xuanvuong1702/camera-4G/hardware/kicad/CAM4G/CAM4G-bom.csv

Reference | Value | Footprint | Qty
BT1 | CR1220 | Battery_Panasonic_CR1220-VCN_Vertical_CircularHoles | 1
C1 | 10uF | C_0603_1608Metric | 1
C2 | 100nF | C_0603_1608Metric | 1
C3 | 3.3uF | C_0603_1608Metric | 1
C4 | 47uF | C_0603_1608Metric | 1
C5 | 2.2nF | C_0603_1608Metric | 1
C6 | 100nF | C_0603_1608Metric | 1
C7 | 47nF | C_0603_1608Metric | 1
C8 | DNP | C_0603_1608Metric | 1
C9 | 1uF | C_0603_1608Metric | 1
C10 | 4.7uF | C_0603_1608Metric | 1
C11 | 10uF | C_0603_1608Metric | 1
C12 | 100nF | C_0603_1608Metric | 1
C13 | 10uF | C_0603_1608Metric | 1
C14 | 10uF | C_0603_1608Metric | 1
C15 | 100nF | C_0603_1608Metric | 1
C16 | 100nF | C_0603_1608Metric | 1
C17 | 100nF | C_0603_1608Metric | 1
C18 | 1uF | C_0603_1608Metric | 1
C19 | 100nF | C_0603_1608Metric | 1
D1 | RED | LED_0603_1608Metric | 1
D2 | GRN | LED_0603_1608Metric | 1
D3 | PWR | LED_0603_1608Metric | 1
D5 | BAT54 | D_SOD-323 | 1
D6 | BAT54 | D_SOD-323 | 1
J1 | USB-C | USB_C_Receptacle_HRO_TYPE-C-31-M-12 | 1
J2 | BAT | JST_VH_B2P-VH_1x02_P3.96mm_Vertical | 1
J3 | CAM 20P | Hirose_FH12-20S-0.5SH_1x20-1MP_P0.50mm_Horizontal | 1
J4 | microSD | microSD_HC_Hirose_DM3AT-SF-PEJM5 | 1
J6 | PIR | JST_XH_B3B-XH-A_1x03_P2.50mm_Vertical | 1
J7 | IR LED | JST_XH_B2B-XH-A_1x02_P2.50mm_Vertical | 1
J8 | IR-CUT | JST_XH_B2B-XH-A_1x02_P2.50mm_Vertical | 1
J9 | DS18B20 | JST_XH_B3B-XH-A_1x03_P2.50mm_Vertical | 1
J10 | DS18B20 | JST_XH_B3B-XH-A_1x03_P2.50mm_Vertical | 1
J11 | MODEM | PinHeader_2x06_P1.27mm_Vertical | 1
J12 | DEBUG UART | PinHeader_1x03_P2.54mm_Vertical | 1
J13 | SWD | PinHeader_1x04_P2.54mm_Vertical | 1
L1 | 1.2uH | L_Bourns-SRN8040_8x8.15mm | 1
L2 | 2.2uH | L_Bourns-SRN4018 | 1
NTC1 | 10k B3950 | R_0603_1608Metric | 1
Q1 | AO3401 | SOT-23 | 1
Q2 | 2N3904 | SOT-23 | 1
Q3 | AO3400A | SOT-23 | 1
R1 | 178k | R_0603_1608Metric | 1
R2 | 56k | R_0603_1608Metric | 1
R3 | 267k | R_0603_1608Metric | 1
R4 | 64.9k | R_0603_1608Metric | 1
R5 | 10.5k | R_0603_1608Metric | 1
R6 | 267k | R_0603_1608Metric | 1
R7 | 0.01R | R_2512_6332Metric | 1
R8 | 4.7k | R_0603_1608Metric | 1
R9 | 4.7k | R_0603_1608Metric | 1
R10 | 2.4k | R_0603_1608Metric | 1
R11 | 1k | R_0603_1608Metric | 1
R12 | 1k | R_0603_1608Metric | 1
R13 | 7.15k | R_0603_1608Metric | 1
R14 | 5.1k | R_0603_1608Metric | 1
R15 | 5.1k | R_0603_1608Metric | 1
R16 | 100k | R_0603_1608Metric | 1
R17 | 10k | R_0603_1608Metric | 1
R18 | 100k | R_0603_1608Metric | 1
R19 | 100R | R_0603_1608Metric | 1
R20 | 100k | R_0603_1608Metric | 1
R21 | 1k | R_0603_1608Metric | 1
R23 | 10k | R_0603_1608Metric | 1
R24 | 0R | R_0603_1608Metric | 1
R25 | 10k | R_0603_1608Metric | 1
R31 | 0R | R_0603_1608Metric | 1
R32 | 0R | R_0603_1608Metric | 1
R33 | 0R | R_0603_1608Metric | 1
R34 | 10k | R_0603_1608Metric | 1
R35 | 10k | R_0603_1608Metric | 1
SW1 | RESET | SW_SPST_B3S-1000 | 1
TP1 | TP_3V3 | TestPoint_Pad_1.5x1.5mm | 1
TP2 | TP_1V8 | TestPoint_Pad_1.5x1.5mm | 1
U1 | Core1106 | Core1106-SMT | 1
U2 | TPS61088 | VQFN-20_3.5x3.5 | 1
U3 | TPS62840 | SON_DLC_1.5x2 | 1
U4 | INA226 | MSOP-10_3x3mm_P0.5mm | 1
U5 | CN3058E | SOIC-8-1EP_3.9x4.9mm_P1.27mm_EP2.41x3.3mm | 1
U6 | STM32L011F4 | TSSOP-20_4.4x6.5mm_P0.65mm | 1
