xuanvuong1702/camera-4G/hardware/kicad/CAM4G/CAM4G.step

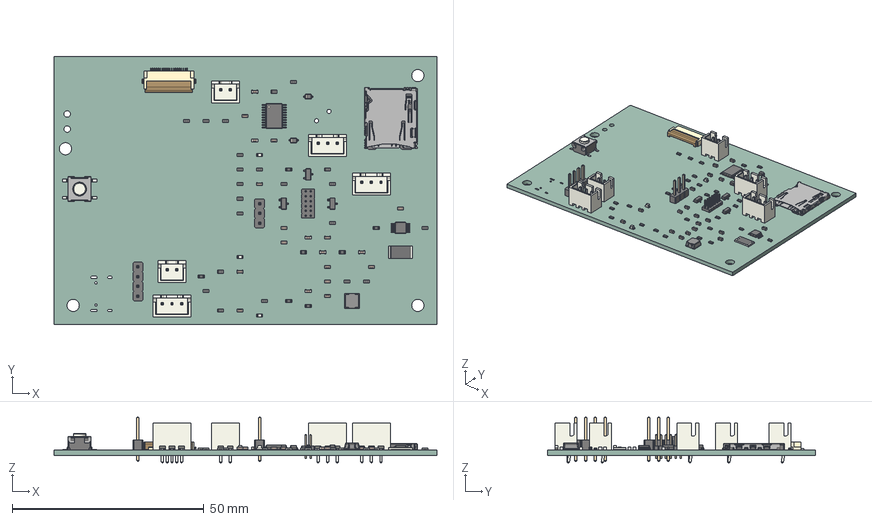
[picture p1: CAD file, 2026-11-09]
hardware/kicad/CAM4G/CAM4G.step
100.0 x 70.0 x 11.9 mm
C_0603_1608Metric x 19
R_0603_1608Metric x 29
LED_0603_1608Metric x 3
D_SOD-323 x 2
MSOP-10_3x3mm_P0.5mm
L_Bourns-SRN4018
R_2512_6332Metric
PinHeader_1x03_P254mm_Vertical
JST_B2B_XH_A x 2
lock
pins
JST_B3B_XH_A x 3
PinHeader_1x04_P254mm_Vertical
SOT-23 x 3
TSSOP-20_4.4x6.5mm_P0.65mm
PinHeader_2x06_P127mm_Vertical
microSD_HC_Hirose_DM3AT-SF-PEJM5
SW_SPST_B3S-1000
CAM4G_PCB
