xuanvuong1702/camera-4G/hardware/kicad/CAM4G/CAM4G-schematic-preview.pdf

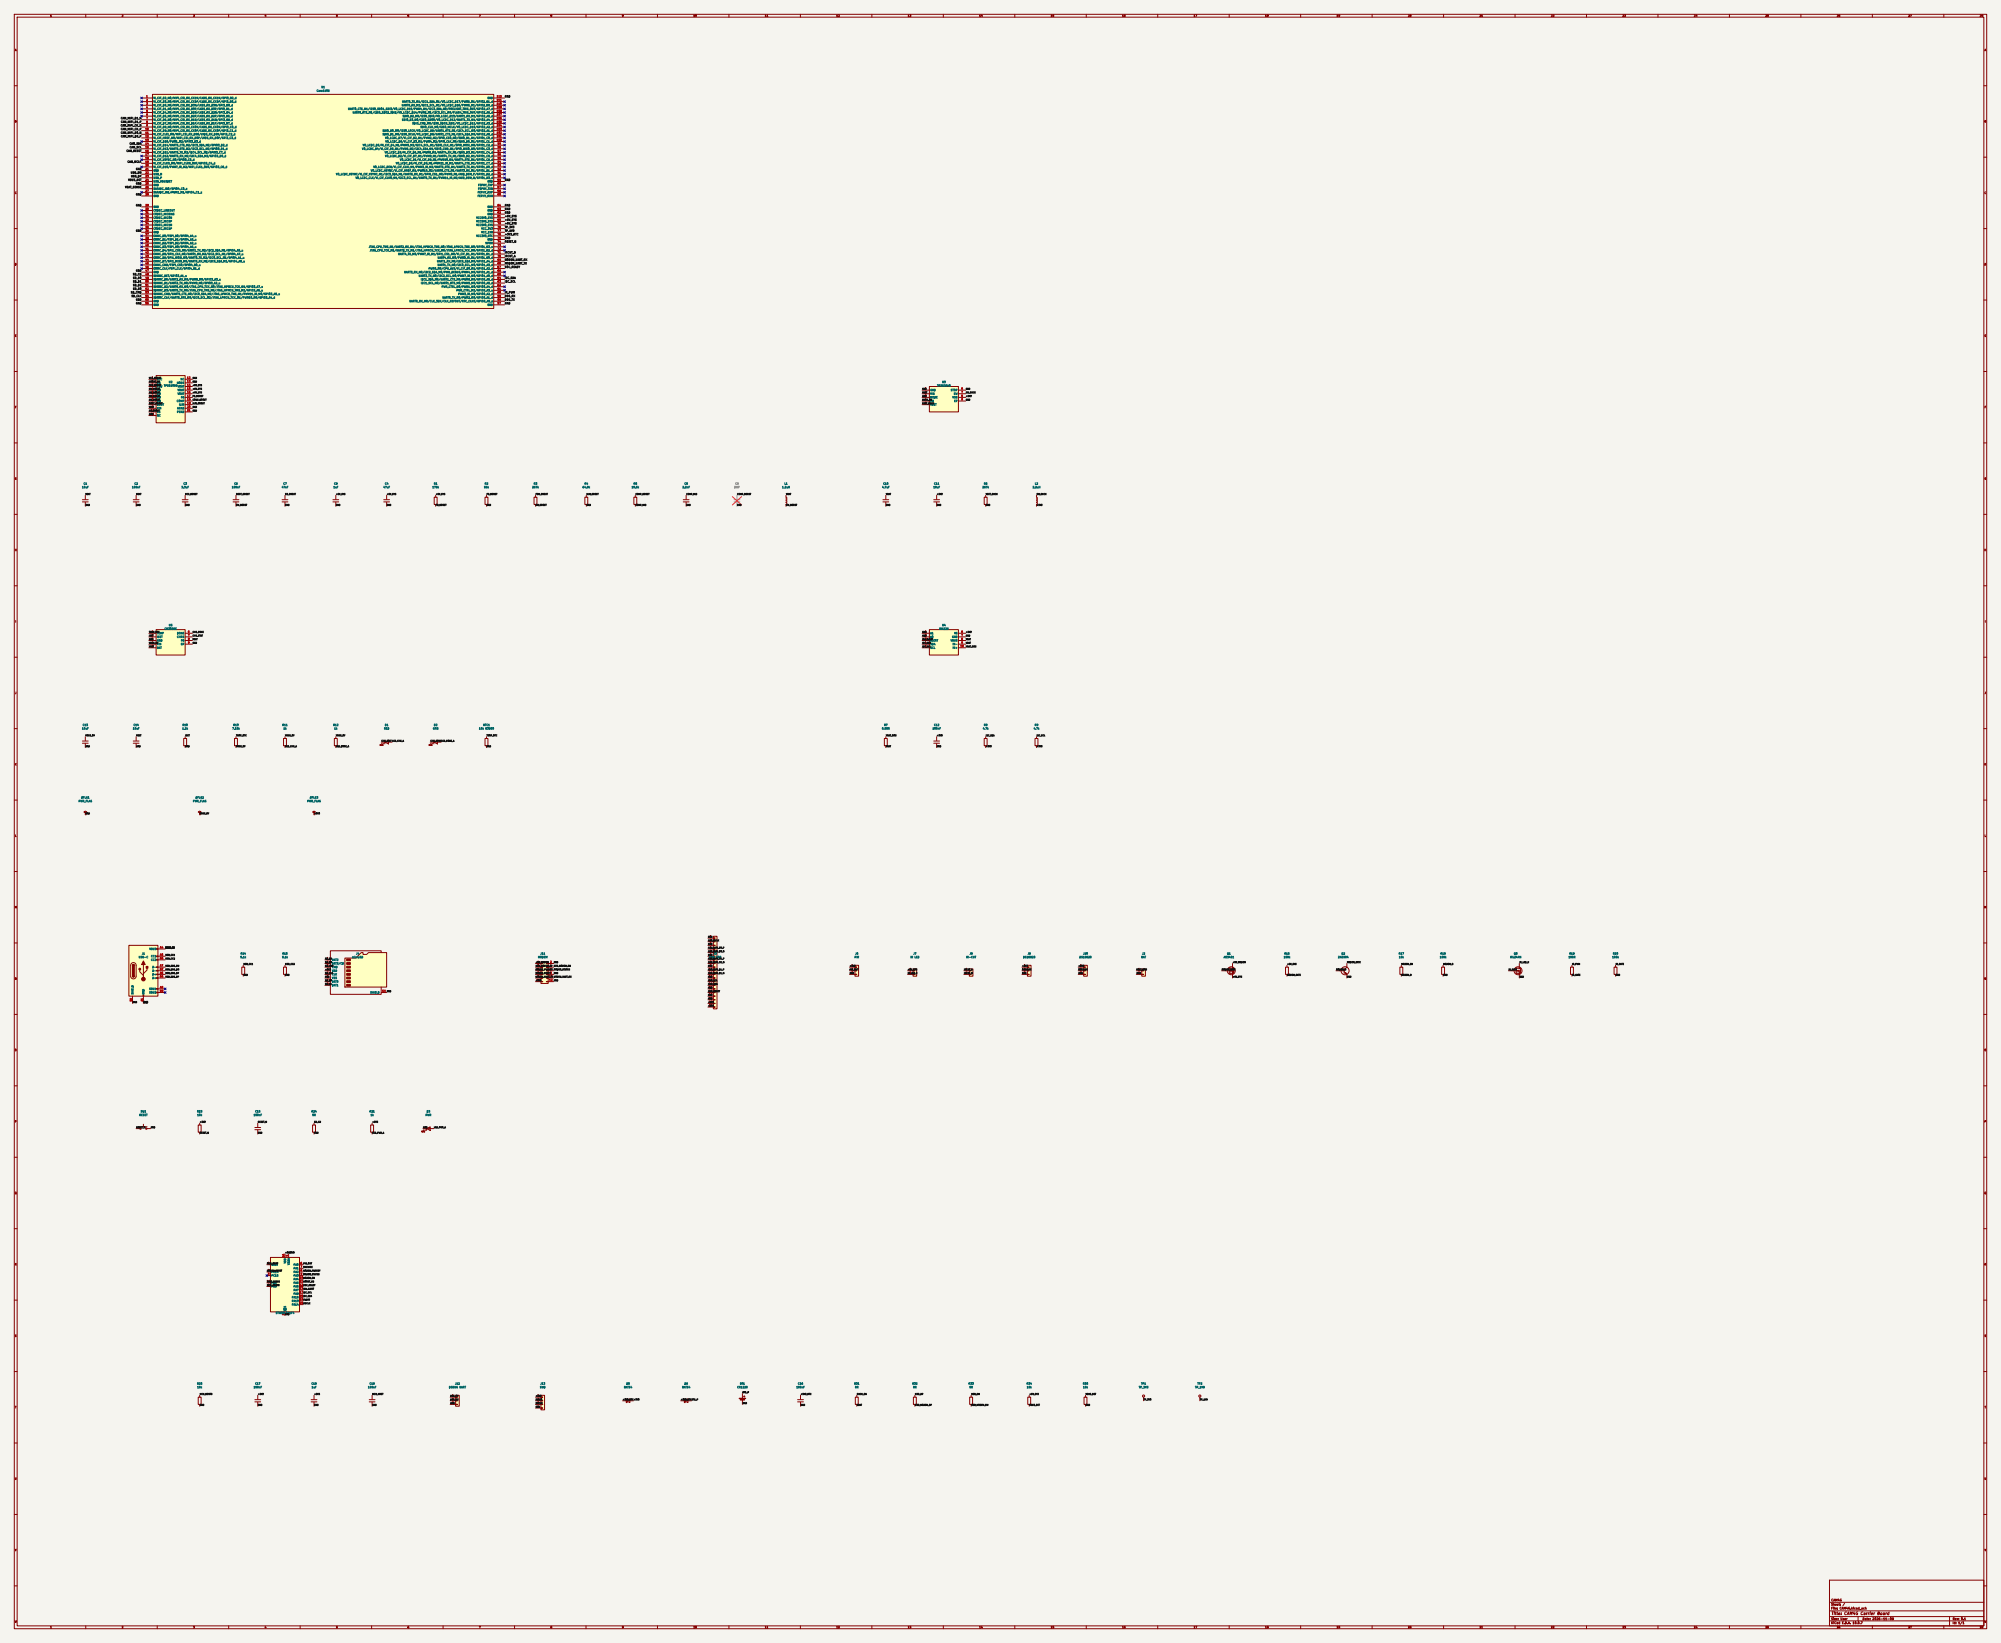
[picture p2: page 1]

Size: User | Rev: 0.1
KiCad E.D.A. 10.0.7 | Id: 1/1
