xuanvuong1702/camera-4G/hardware/kicad/CAM4G/CAM4G-1to1.pdf

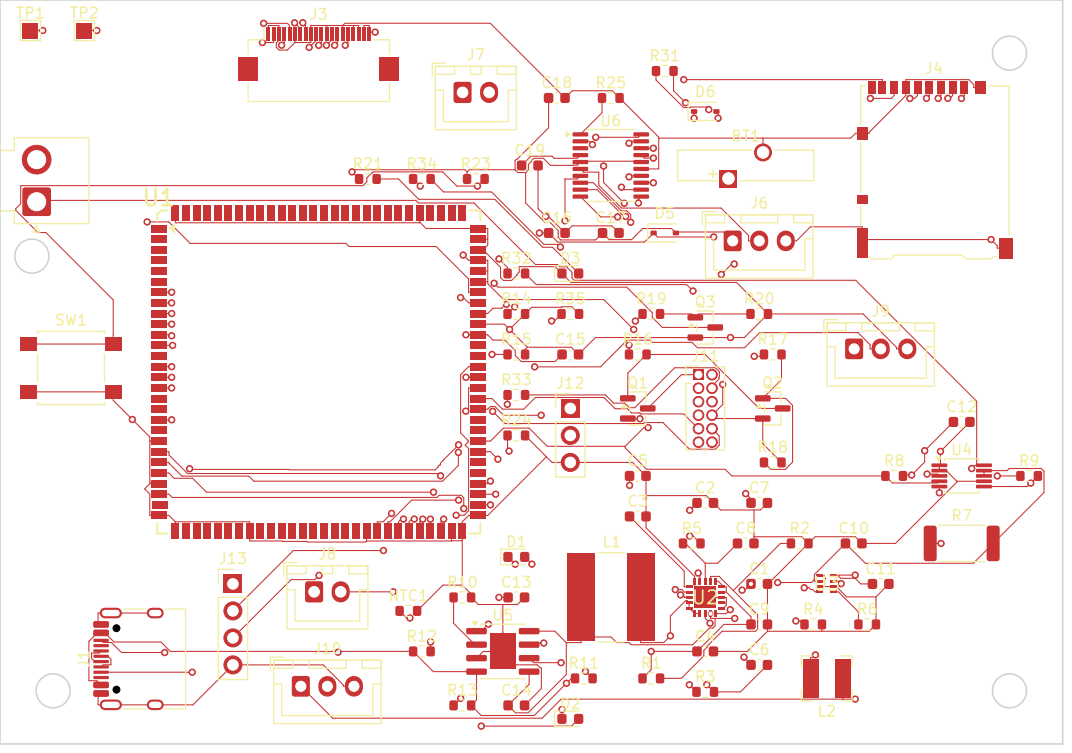
[picture p3: page 1]
