xuanvuong1702/camera-4G/hardware/kicad/CAM4G/CAM4G-pcb-preview.pdf

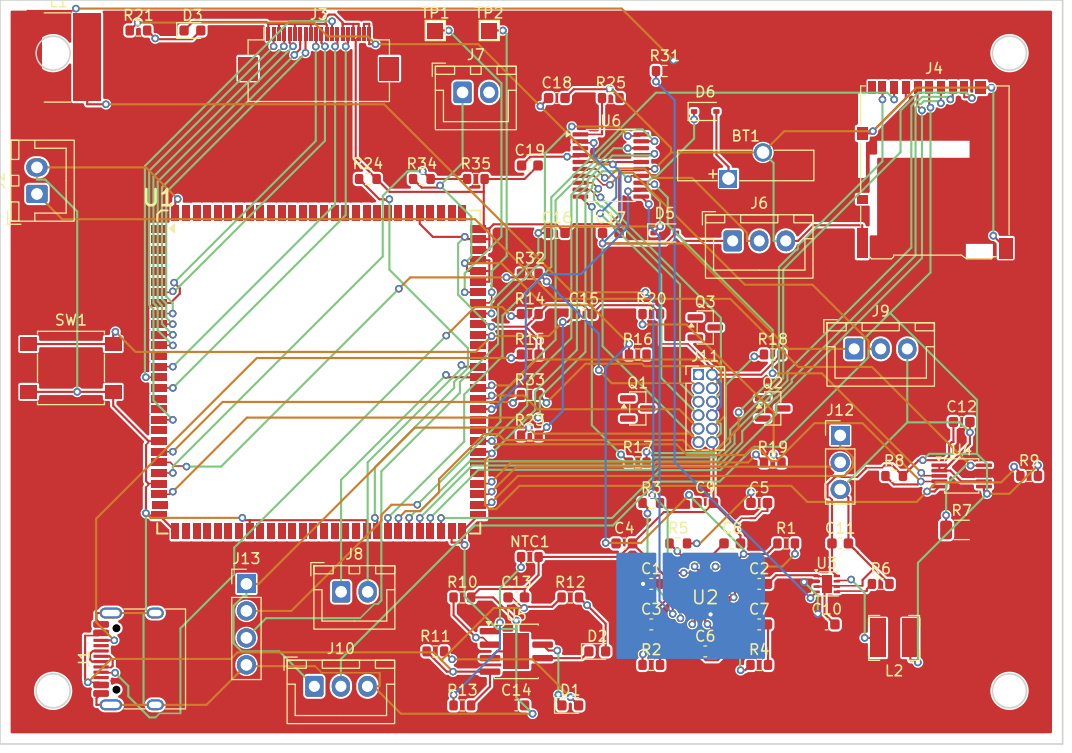
[picture p4: page 1]
