xuanvuong1702/camera-4G/hardware/kicad/CAM4G/CAM4G.kicad_pcb

## KiCad design hardware/kicad/CAM4G/CAM4G.kicad_pcb (2026-11-09)

Schematic: CAM4G.kicad_sch, CAM4G Carrier Board

Parts:
BT1: CR1220; Battery_Panasonic_CR1220-VCN_Vertical_CircularHoles
C1, C11, C13, C14: 10uF; C_0603_1608Metric
C2, C6, C12, C15, C16, C17, C19: 100nF; C_0603_1608Metric
C3: 3.3uF; C_0603_1608Metric
C4: 47uF; C_0603_1608Metric
C5: 2.2nF; C_0603_1608Metric
C7: 47nF; C_0603_1608Metric
C8: DNP; C_0603_1608Metric; not fitted
C9, C18: 1uF; C_0603_1608Metric
C10: 4.7uF; C_0603_1608Metric
D1: RED; LED_0603_1608Metric
D2: GRN; LED_0603_1608Metric
D3: PWR; LED_0603_1608Metric
D5, D6: BAT54; D_SOD-323
J1: USB-C; USB_C_Receptacle_HRO_TYPE-C-31-M-12
J2: BAT; JST_VH_B2P-VH_1x02_P3.96mm_Vertical
J3: CAM 20P; Hirose_FH12-20S-0.5SH_1x20-1MP_P0.50mm_Horizontal
J4: microSD; microSD_HC_Hirose_DM3AT-SF-PEJM5
J6: PIR; JST_XH_B3B-XH-A_1x03_P2.50mm_Vertical
J7: IR LED; JST_XH_B2B-XH-A_1x02_P2.50mm_Vertical
J8: IR-CUT; JST_XH_B2B-XH-A_1x02_P2.50mm_Vertical
J9, J10: DS18B20; JST_XH_B3B-XH-A_1x03_P2.50mm_Vertical
J11: MODEM; PinHeader_2x06_P1.27mm_Vertical
J12: DEBUG UART; PinHeader_1x03_P2.54mm_Vertical
J13: SWD; PinHeader_1x04_P2.54mm_Vertical
L1: 1.2uH; L_Bourns-SRN8040_8x8.15mm
L2: 2.2uH; L_Bourns-SRN4018
NTC1: 10k B3950; R_0603_1608Metric
Q1: AO3401; SOT-23
Q2: 2N3904; SOT-23
Q3: AO3400A; SOT-23
R1: 178k; R_0603_1608Metric
R2: 56k; R_0603_1608Metric
R3, R6: 267k; R_0603_1608Metric
R4: 64.9k; R_0603_1608Metric
R5: 10.5k; R_0603_1608Metric
R7: 0.01R; R_2512_6332Metric
R8, R9: 4.7k; R_0603_1608Metric
R10: 2.4k; R_0603_1608Metric
R11, R12, R21: 1k; R_0603_1608Metric
R13: 7.15k; R_0603_1608Metric
R14, R15: 5.1k; R_0603_1608Metric
R16, R18, R20: 100k; R_0603_1608Metric
R17, R23, R25, R34, R35: 10k; R_0603_1608Metric
R19: 100R; R_0603_1608Metric
R24, R31, R32, R33: 0R; R_0603_1608Metric
SW1: RESET; SW_SPST_B3S-1000
TP1: TP_3V3; TestPoint_Pad_1.5x1.5mm
TP2: TP_1V8; TestPoint_Pad_1.5x1.5mm
U1: Core1106; Core1106-SMT
U2: TPS61088; VQFN20_3.5
U3: TPS62840; DLC0008B
U4: INA226; MSOP-10_3x3mm_P0.5mm
U5: CN3058E; SOIC-8-1EP_3.9x4.9mm_P1.27mm_EP2.41x3.3mm
U6: STM32L011F4; TSSOP-20_4.4x6.5mm_P0.65mm

Connections:
/+3V3: C11.1, C12.1, C17.1, C18.1, D5.2 (A), J3.19, J3.20, J4.4 (VDD), J6.1, J9.1, J10.1, J11.11, J13.1, L2.2, R8.2, R9.2, R21.1, R23.1, U3.8 (VOS), U4.6 (VS), U6.5 (VDDA), U6.16 (VDD)
/+3V3_RTC: C16.1, D5.1 (K), D6.1 (K), U1.76 (VCC3V3_RTC)
/+5V_MODEM: J11.1, Q1.3 (D)
/+5V_SYS: C4.1, C9.1, J7.1, Q1.2 (S), R1.1, R16.1, U1.79 (VCC5V0_SYS), U1.80 (VCC5V0_SYS), U1.81 (VCC5V0_SYS), U2.14 (VOUT), U2.15 (VOUT), U2.16 (VOUT)
/BOOST_EN: U2.2 (EN), U6.11 (PA5)
/BOOT_BOOST: C6.1, U2.8 (BOOT)
/BT1_P: BT1.1 (+), D6.2 (A)
/BUCK_EN: R31.1, U3.4 (EN)
/CAM_MCLK: J3.2, U1.19 (VI_CIF_CLKO_M0/MIPI_CLK0_OUT/GPIO3_C4_d)
/CAM_MIPI_CK_N: J3.8, U1.9 (VI_CIF_D8_M0/MIPI_CSI_RX_CK0N/LVDS_RX_C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)
/CAM_MIPI_CK_P: J3.7, U1.10 (VI_CIF_D9_M0/MIPI_CSI_RX_CK0P/LVDS_RX_C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)
/CAM_MIPI_D0_N: J3.5, U1.11 (VI_CIF_CLKI_M0/MIPI_CSI_RX_D0N/LVDS_RX_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)
/CAM_MIPI_D0_P: J3.4, U1.12 (VI_CIF_HREF_M0/MIPI_CSI_RX_D0P/LVDS_RX_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)
/CAM_MIPI_D1_N: J3.11, U1.7 (VI_CIF_D6_M0/MIPI_CSI_RX_D1N/LVDS_RX_D1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)
/CAM_MIPI_D1_P: J3.10, U1.8 (VI_CIF_D7_M0/MIPI_CSI_RX_D1P/LVDS_RX_D1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)
/CAM_RESET: J3.16, U1.16 (VI_CIF_D11/UART5_TX_M2/I2C4_SCL_M2/GPIO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)
/CAM_SCL: J3.13, U1.15 (VI_CIF_D13/UART5_RTS_M2/I2C3_SCL_M2/GPI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)
/CAM_SDA: J3.14, U1.14 (VI_CIF_D14/UART5_CTS_M2/I2C3_SDA_M2/GPI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)
/CHG_DONE: D2.1 (K), U5.6 (DONE)
/CHG_STAT: D1.1 (K), U5.7 (CHRG)
/COMP_BOOST: C8.1, R5.1, U2.18 (COMP)
/COMP_MID: C5.1, R5.2
/DBG_RX: J12.2, U1.59 (UART0_TX_M0/PWM2_M0/GPIO0_A1_d)
/DBG_TX: J12.1, U1.58 (UART0_RX_M0/CLK_32K/CLK_REFOUT/RTC_CLKO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)
/FB_BOOST: R1.2, R2.1, U2.17 (FB)
/FSW_BOOST: R3.1, U2.3 (FSW)
/GND: BT1.2 (-), C1.2, C2.2, C3.2, C4.2, C5.2, C7.2, C8.2, C9.2, C10.2, C11.2, C12.2, C13.2, C14.2, C15.2, C16.2, C17.2, C18.2, C19.2, D3.1 (K), J1.A1 (GND), J1.A12 (GND), J1.B1 (GND), J1.B12 (GND), J1.SH (SHIELD), J2.2, J3.1, J3.3, J3.6, J3.9, J3.12, J3.15, J3.17, J3.18, J4.6 (VSS), J4.SH (SHIELD), J6.3, J9.3, J10.3, J11.2, J11.8, J11.12, J12.3, J13.4, NTC1.2, Q2.2 (E), Q3.2 (S), R2.2, R4.2, R6.2, R10.2, R14.2, R15.2, R18.2, R20.2, R24.2, R25.2, R35.2, SW1.2, U1.21 (GND), U1.25 (GND), U1.28 (GND), U1.29 (GND), U1.36 (GND), U1.47 (GND), U1.55 (GND), U1.56 (GND), U1.57 (GND), U1.75 (GND), U1.82 (GND), U1.83 (GND), U1.84 (GND), U1.89 (GND), U1.112 (GND), U2.11 (NC), U2.12 (NC), U2.13 (MODE), U2.20 (AGND), U2.21 (PGND), U3.1 (GND), U3.3 (MODE), U3.6 (STOP), U4.1 (A1), U4.2 (A0), U4.7 (GND), U5.3 (GND), U5.9 (EP), U6.15 (VSS)
/I2C_SCL: R9.1, U1.63 (I2C1_SCL_M0/UART1_RTS_M0/PWM5_M0/GPIO0_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), U4.5 (SCL), U6.17 (PA9)
/I2C_SDA: R8.1, U1.64 (I2C1_SDA_M0/UART1_CTS_M0/PWM6_M0/GPIO0_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), U4.4 (SDA), U6.18 (PA10)
/ILIM_BOOST: R4.1, U2.19 (ILIM)
/INA_ALERT: U4.3 (ALERT), U6.13 (PA7)
/IRCUT_A: J8.1, U1.70 (UART4_RX_M0/PWM3_IR_M1/GPIO1_B0_d)
/IRCUT_B: J8.2, U1.71 (UART4_TX_M0/PWM7_IR_M1/SPI1_CS1_M0/VI_C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)
/IR_GATE: Q3.1 (G), R19.2, R20.1
/IR_LED_K: J7.2, Q3.3 (D)
/IR_PWM: R19.1, U1.60 (PWM3_IR_M0/GPIO0_A2_d)
/ISET: R10.1, U5.2 (ISET)
/LED_CHG_A: D1.2 (A), R11.2
/LED_DONE_A: D2.2 (A), R12.2
/LED_PWR_A: D3.2 (A), R21.2
/MCU_BOOT0: R25.1, U6.1 (PB9)
/MCU_NRST: C19.1, U6.4 (NRST)
/MODEM_B: Q2.1 (B), R17.2, R18.1
/MODEM_EN: R17.1, U6.10 (PA4)
/MODEM_GATE: Q1.1 (G), Q2.3 (C), R16.2
/MODEM_PWRKEY: J11.5, U6.8 (PA2)
/MODEM_RESET: J11.7, U6.2 (PC14)
/MODEM_STATUS: J11.6, U6.9 (PA3)
/MODEM_UART_RX: J11.10, U1.69 (UART1_RX_M0/I2C0_SDA_M0/GPIO1_A4_d)
/MODEM_UART_TX: J11.9, U1.68 (UART1_TX_M0/I2C0_SCL_M0/GPIO1_A3_d)
/ONEWIRE: J9.2, J10.2, U6.7 (PA1)
/PIR_OUT: J6.2, U6.6 (PA0)
/RESET_N: C15.1, R23.2, SW1.1, U1.74 (NPOR)
/SD_CD: R24.1, U1.48 (SDMMC_DET/GPIO3_A1_u)
/SD_CLK: J4.5 (CLK), U1.54 (SDMMC_CLK/UART5_RTS_M0/I2C0_SCL_M2/JTAG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)
/SD_CMD: J4.3 (CMD), U1.53 (SDMMC_CMD/UART5_CTS_M0/I2C0_SDA_M2/JTAG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)
/SD_D0: J4.7 (DAT0), U1.49 (SDMMC_D0/UART2_RX_M0/PWM8_M0/GPIO3_A3_u)
/SD_D1: J4.8 (DAT1), U1.50 (SDMMC_D1/UART2_TX_M0/PWM9_M0/GPIO3_A2_u)
/SD_D2: J4.1 (DAT2), U1.51 (SDMMC_D2/UART5_RX_M0/JTAG_CPU_TCK_M0/JT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)
/SD_D3: J4.2 (DAT3/CD), U1.52 (SDMMC_D3/UART5_TX_M0/JTAG_CPU_TMS_M0/JT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)
/SOC_READY: U1.67 (PWM0_M0/CPU_AVS/VI_CIF_D0_M1/GPIO1_A2_d), U6.12 (PA6)
/SS_BOOST: C7.1, U2.10 (SS)
/SWCLK: J13.3, U6.20 (PA14)
/SWDIO: J13.2, U6.19 (PA13)
/SW_BOOST: C6.2, L1.2, R3.2, U2.4 (SW), U2.5 (SW), U2.6 (SW), U2.7 (SW)
/SW_BUCK: L2.1, U3.7 (SW)
/TEMP_NTC: NTC1.1, R13.1, U5.1 (TEMP)
/TP_1V8: TP2.1, U1.77 (VCC_1V8)
/TP_3V3: TP1.1, U1.78 (VCC_3V3)
/USB_CC1: J1.A5 (CC1), R14.1
/USB_CC2: J1.B5 (CC2), R15.1
/USB_DBG_DM: J1.A7 (D-), J1.B7 (D-)
/USB_DBG_DP: J1.A6 (D+), J1.B6 (D+)
/USB_DM: R33.1, U1.22 (USB_N)
/USB_DP: R32.1, U1.23 (USB_P)
/USB_MODEM_DM: J11.4, R33.2
/USB_MODEM_DP: J11.3, R32.2
/VBAT: C1.1, C2.1, C10.1, C14.1, L1.1, R7.2, R31.2, U2.9 (VIN), U3.2 (VIN), U4.8 (VBUS), U4.9 (IN-), U5.5 (BAT), U5.8 (FB)
/VBAT_BMS: J2.1, R7.1, U4.10 (IN+)
/VBAT_SENSE: U1.26 (SARADC_IN0/GPIO4_C0_z), U6.14 (PB1)
/VBUS_5V: C13.1, J1.A4 (VBUS), J1.A9 (VBUS), J1.B4 (VBUS), J1.B9 (VBUS), R11.1, R12.1, R13.2, R34.1, U5.4 (VIN)
/VBUS_DET: R34.2, R35.1, U1.24 (USB_VBUSDET)
/VCC_BOOST: C3.1, U2.1 (VCC)
/VSET_BUCK: R6.1, U3.5 (VSET)

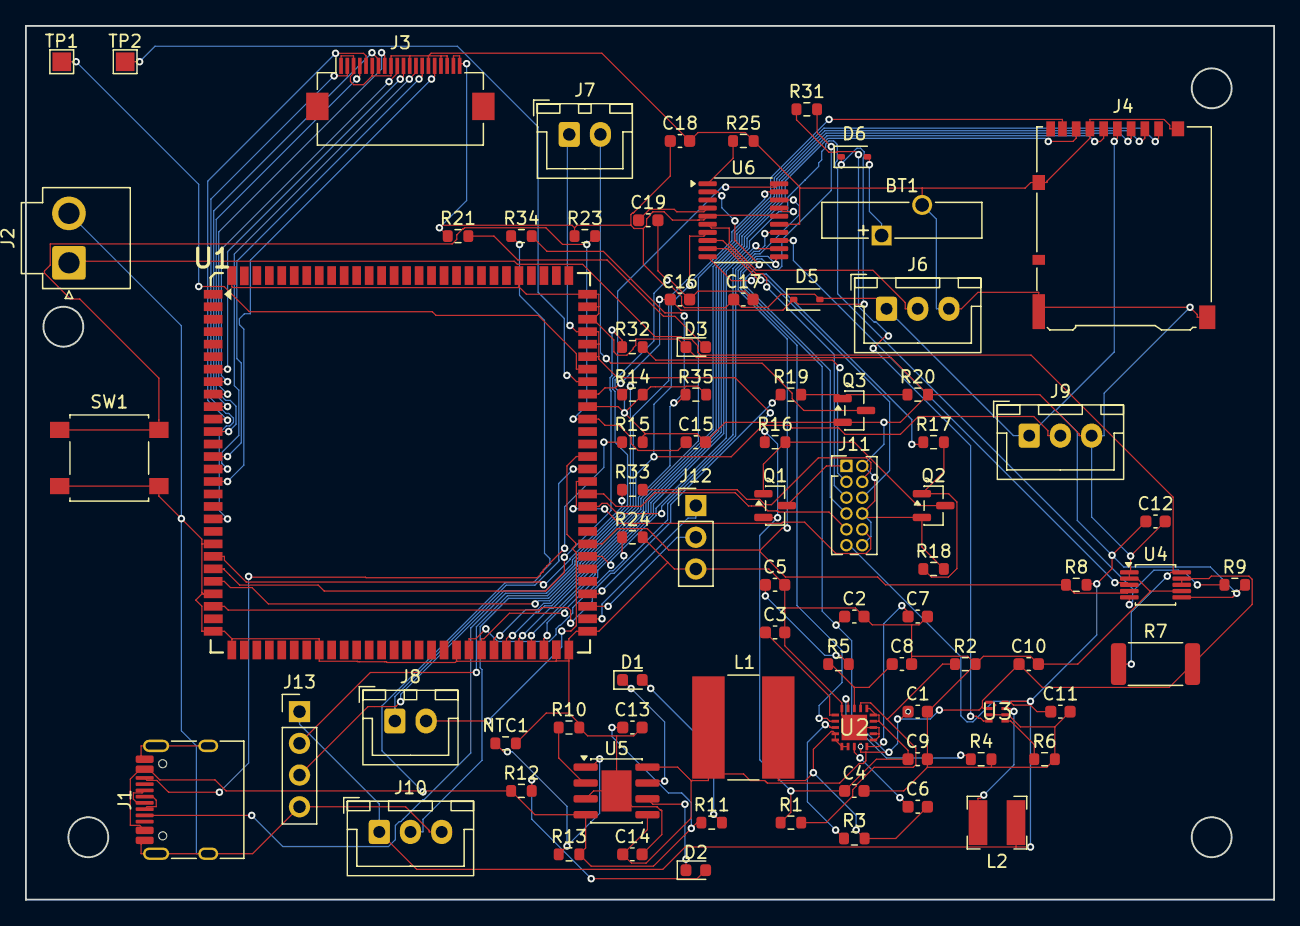
[picture p5: board CAM4G.kicad_pcb from above]

Board: 4 copper layers, 100.0 x 70.0 mm, 81 parts (0 on the bottom side), 84 nets.
