xuanvuong1702/camera-4G/(commit log)

2026-11-09 CAM4G v4: clean dev baseline (schematic, PCB, Gerber/BOM/CPL, firmware, docs)
    [CAM4G-B_Courtyard.gbr, CAM4G-B_Cu.gbl, CAM4G-B_Fab.gbr, CAM4G-B_Mask.gbs, CAM4G-B_Paste.gbp, CAM4G-B_Silkscreen.gbo, CAM4G-Edge_Cuts.gm1, CAM4G-F_Courtyard.gbr]
2026-11-09 audit: readiness review, fix BOM values, procurement BOM, fab Gerber zip
    [CAM4G-bom-procurement.csv, CAM4G-bom.csv, bom-prototype-v3.csv]
2026-11-09 chore: ignore KiCad lock/prl files
2026-11-09 fix: remove F.Cu VBAT plane before routing, DRC clean (0 unconn/short/clearance)
    [CAM4G-B_Courtyard.gbr, CAM4G-B_Cu.gbl, CAM4G-B_Fab.gbr, CAM4G-B_Mask.gbs, CAM4G-B_Paste.gbp, CAM4G-B_Silkscreen.gbo, CAM4G-Edge_Cuts.gm1, CAM4G-F_Courtyard.gbr]
2026-11-09 chore: untrack routing intermediates
    [CAM4G.dsn]
2026-11-09 docs: add component cost estimate for 5-unit prototype run
2026-11-09 fix: U3 DLC footprint, shunt 10mOhm, JST VH, Q1-Q3 pin map, VBUS_DET, power planes
    [CAM4G-B_Courtyard.gbr, CAM4G-B_Cu.gbl, CAM4G-B_Fab.gbr, CAM4G-B_Mask.gbs, CAM4G-B_Paste.gbp, CAM4G-B_Silkscreen.gbo, CAM4G-Edge_Cuts.gm1, CAM4G-F_Courtyard.gbr]
2026-11-09 bom: add package names for custom U2/U3 footprints
    [CAM4G-bom.csv]
2026-11-09 verify: strict ERC/DRC, footprint fields, transistor pin numbers, courtyards, stackup
    [CAM4G.kicad_pcb, CAM4G.kicad_sch]
2026-11-09 fix: move mounting hole off J2, zone priorities, 0.5A charge, docs sync
    [CAM4G-B_Courtyard.gbr, CAM4G-B_Cu.gbl, CAM4G-B_Fab.gbr, CAM4G-B_Mask.gbs, CAM4G-B_Paste.gbp, CAM4G-B_Silkscreen.gbo, CAM4G-Edge_Cuts.gm1, CAM4G-F_Courtyard.gbr]
2026-11-09 chore: fix Core1106 library nickname
    [CAM4G.kicad_pcb, CAM4G.kicad_sch]
2026-11-09 fix: remove U3 EP pin 9, R10 2.4k, C8 DNP, hole/zone updates
    [CAM4G-B_Courtyard.gbr, CAM4G-B_Cu.gbl, CAM4G-B_Fab.gbr, CAM4G-B_Mask.gbs, CAM4G-B_Paste.gbp, CAM4G-B_Silkscreen.gbo, CAM4G-Edge_Cuts.gm1, CAM4G-F_Courtyard.gbr]
2026-11-09 docs: add 3D STEP and 1:1 PDF, record final parity state
    [CAM4G.step]
2026-11-09 verify: zero parity issues, CAM4G lib, courtyards, filters, descriptions
    [CAM4G.kicad_pcb, CAM4G.kicad_sch]
2026-11-09 layout: move L1 next to U2, plane-only inner layers, DRC clean
    [CAM4G-B_Courtyard.gbr, CAM4G-B_Cu.gbl, CAM4G-B_Fab.gbr, CAM4G-B_Mask.gbs, CAM4G-B_Paste.gbp, CAM4G-B_Silkscreen.gbo, CAM4G-Edge_Cuts.gm1, CAM4G-F_Courtyard.gbr]
2026-11-09 export: refresh 3D STEP and 1:1 PDF for new layout
    [CAM4G.step]
